lemwill/QuarkCncQuadDriver/README.md

# QuarkCnc

Inspired from:
https://github.com/Expatria-Technologies/grblhal_2000_PrintNC

https://github.com/grblHAL

3D View of QuarkCnc controller
