lemwill/QuarkCncQuadDriver/step/TS-1187A-B-A-B--3DModel-STEP-56544.STEP

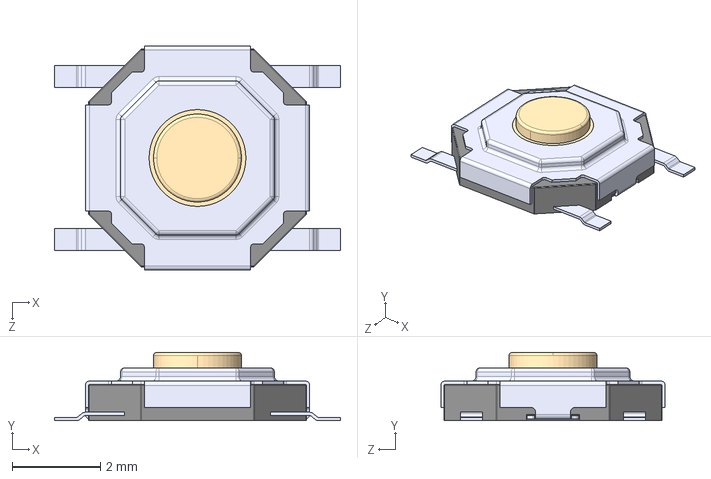
[picture p1: CAD file, 2022-08-06]
step/TS-1187A-B-A-B--3DModel-STEP-56544.STEP
6.50 x 1.55 x 5.10 mm
