lemwill/QuarkCncQuadDriver/QuarkCncQuadDriver.pdf

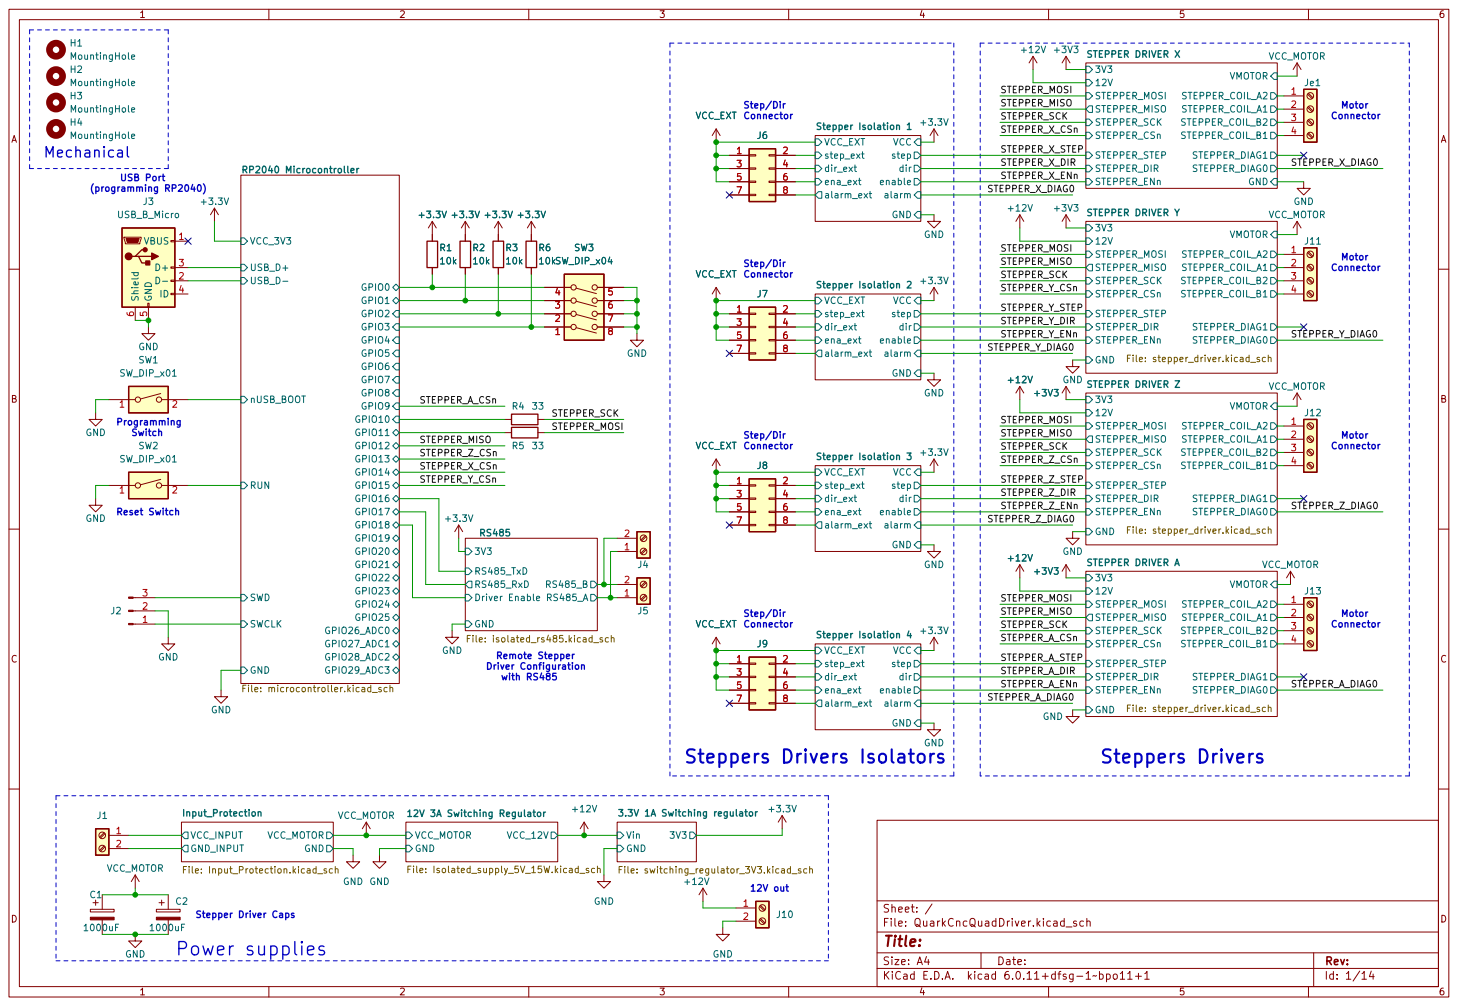
[picture p2: page 1]

3 3 | 4 4
5 5 | 6 6

3 3 | 4 4 | STEPPER_A_DIR

Id: 1/14 Title: File: QuarkCncQuadDriver.kicad_sch Sheet: /

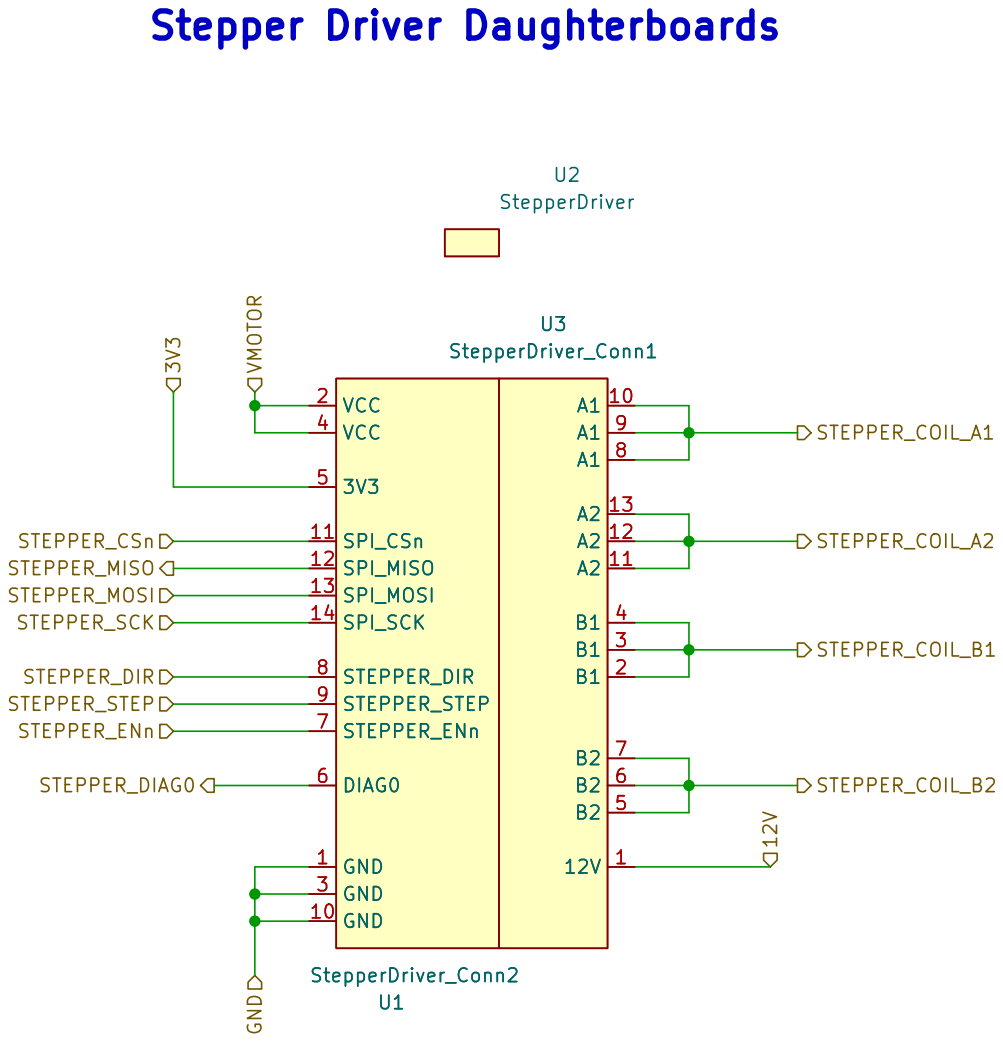
[picture p3: page 2]

Id: 2/14 Title: File: stepper_driver.kicad_sch Sheet: /STEPPER DRIVER Y/

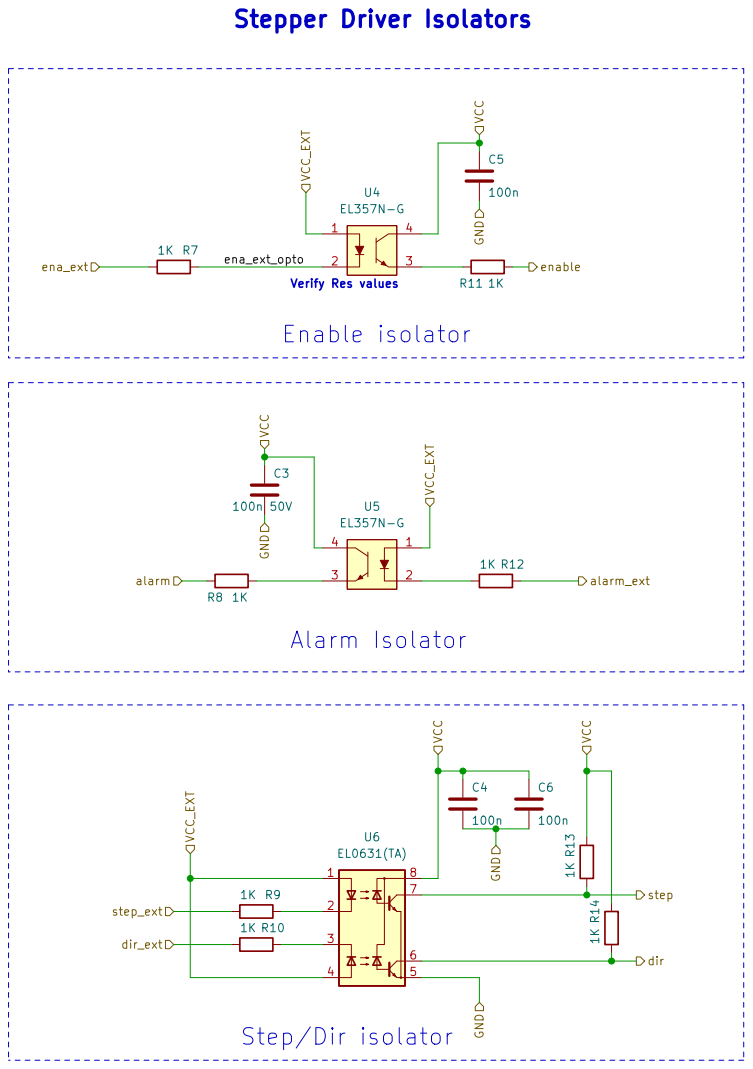
[picture p4: page 3]

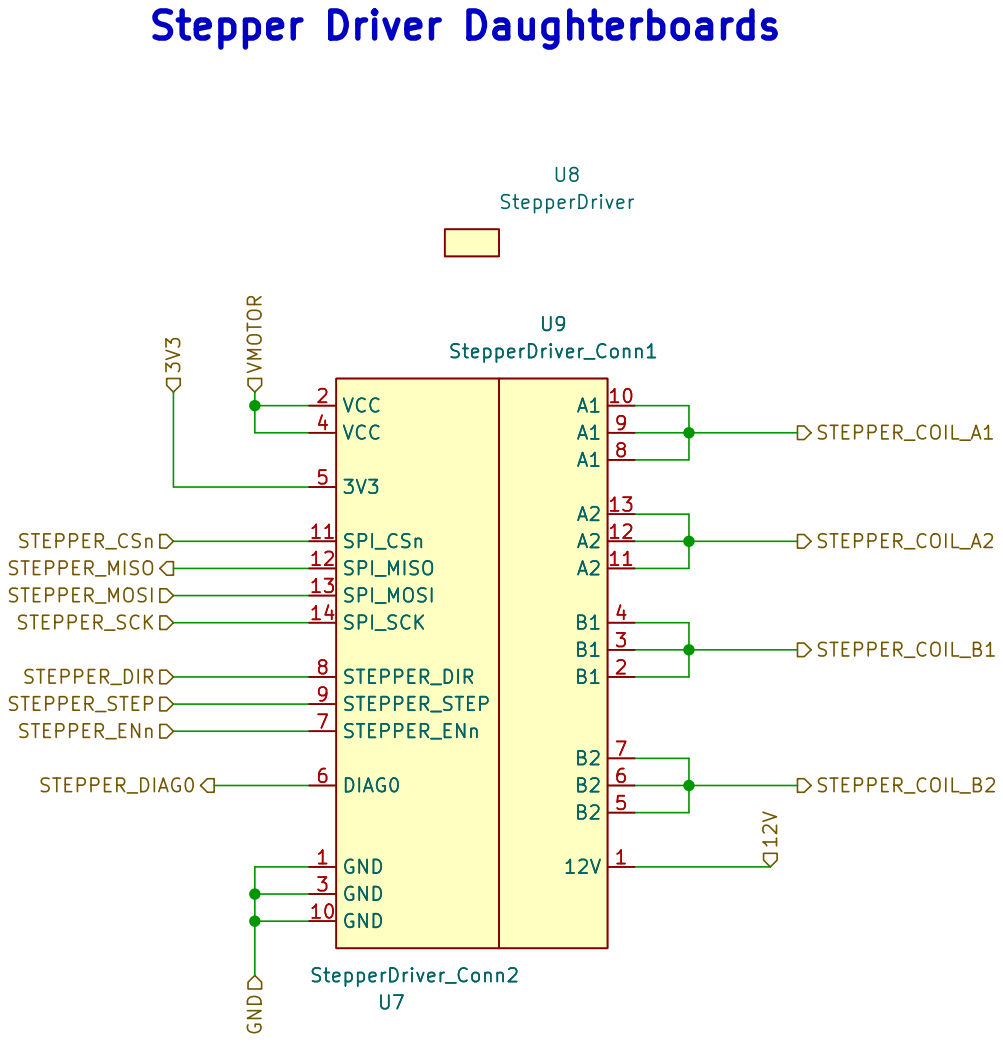
[picture p5: page 4]

Id: 4/14 Title: File: stepper_driver.kicad_sch Sheet: /STEPPER DRIVER X/

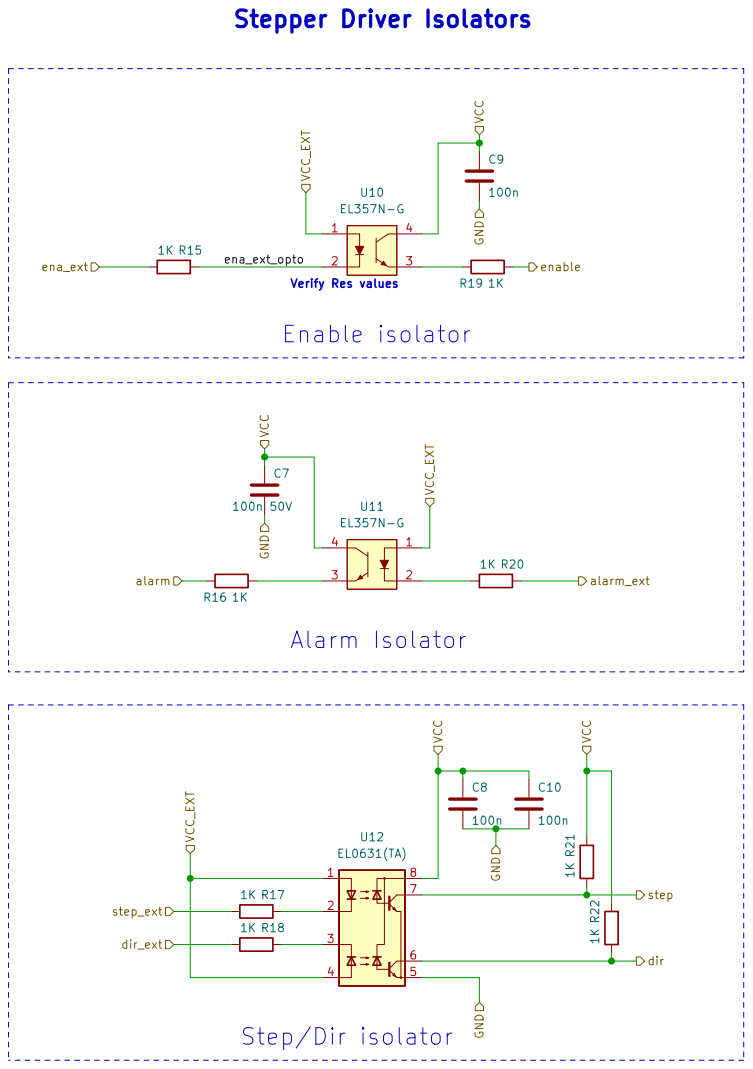
[picture p6: page 5]

Verify Res values Alarm Isolator
Enable isolator

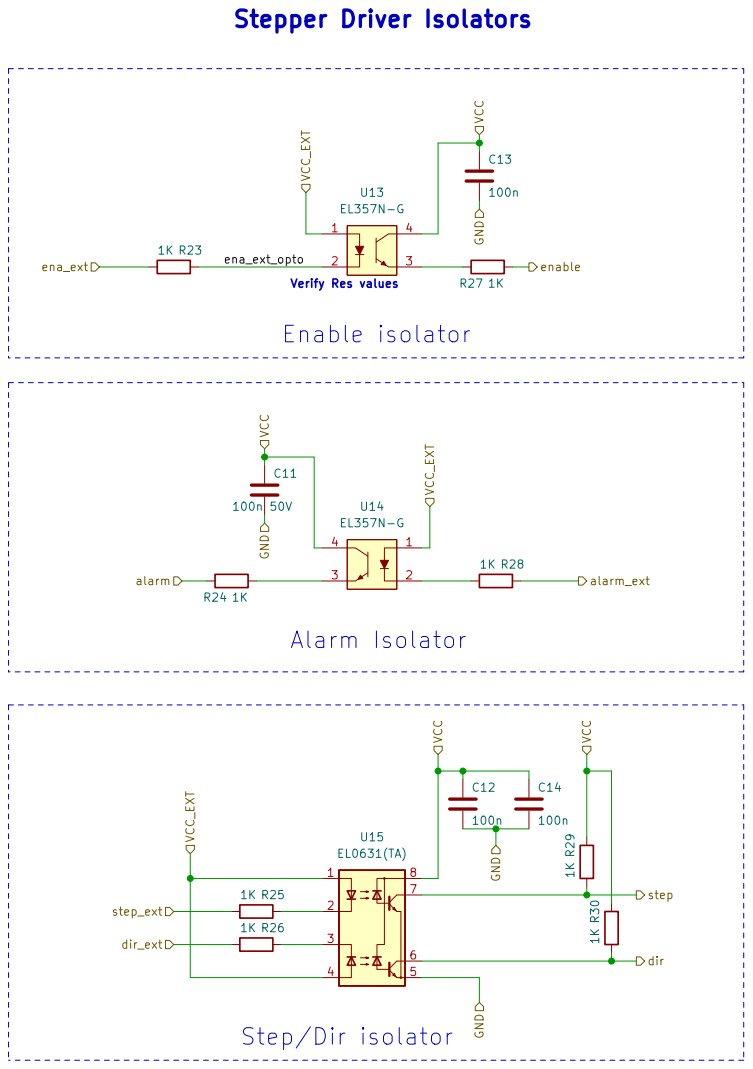
[picture p7: page 6]

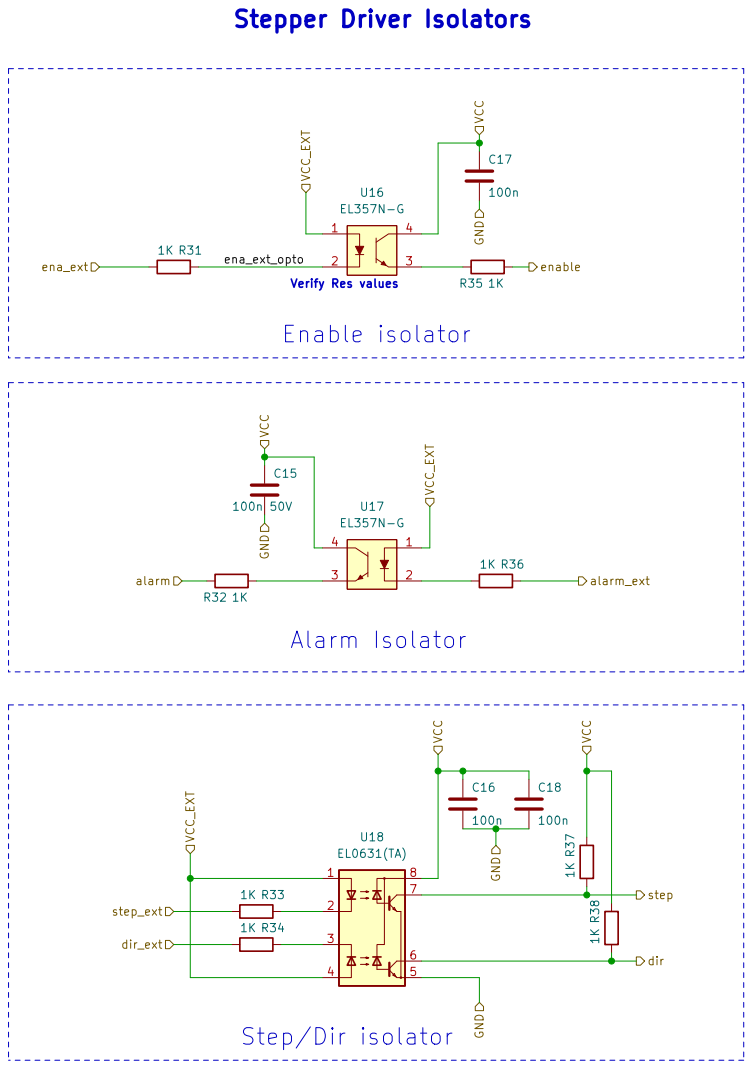
[picture p8: page 7]

dir VCC_EXT
Verify Res values Alarm Isolator
Enable isolator

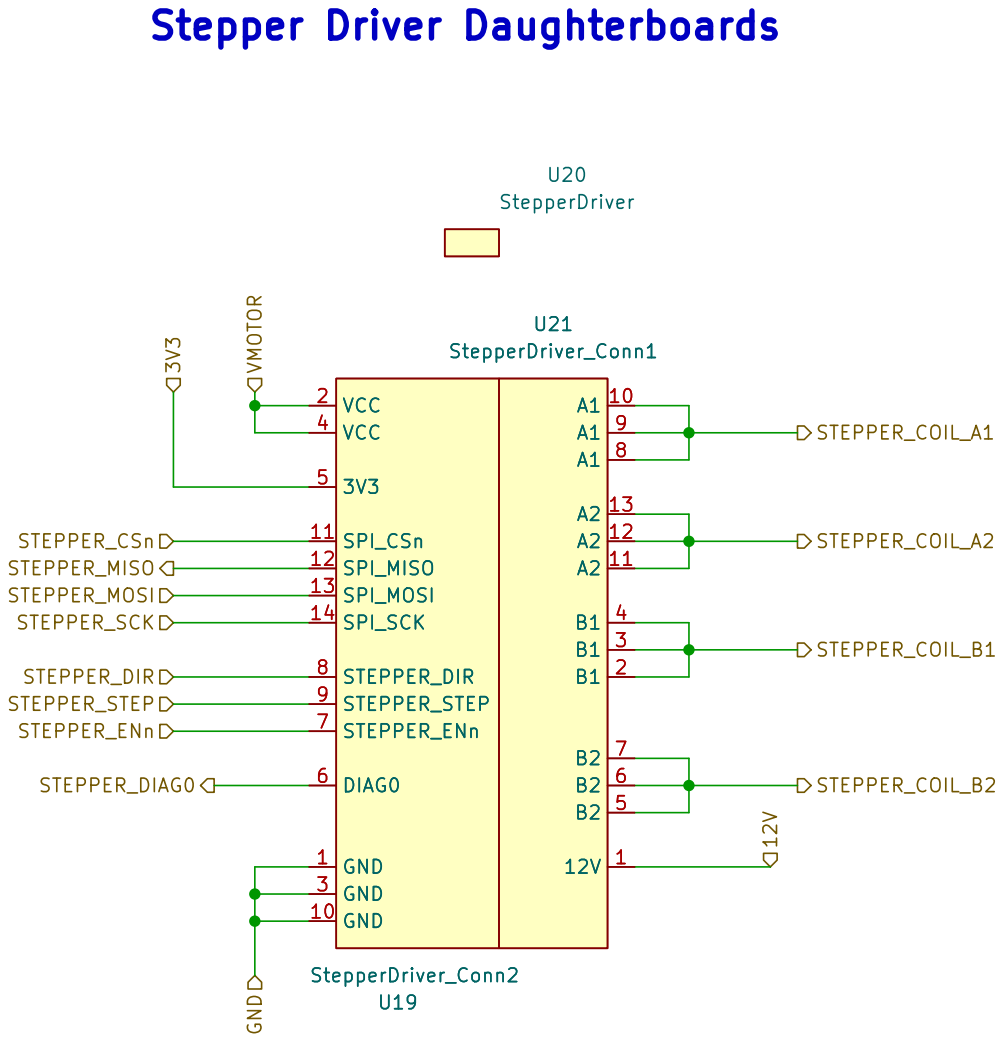
[picture p9: page 8]

Id: 11/14 Title: File: stepper_driver.kicad_sch Sheet: /STEPPER DRIVER Z/

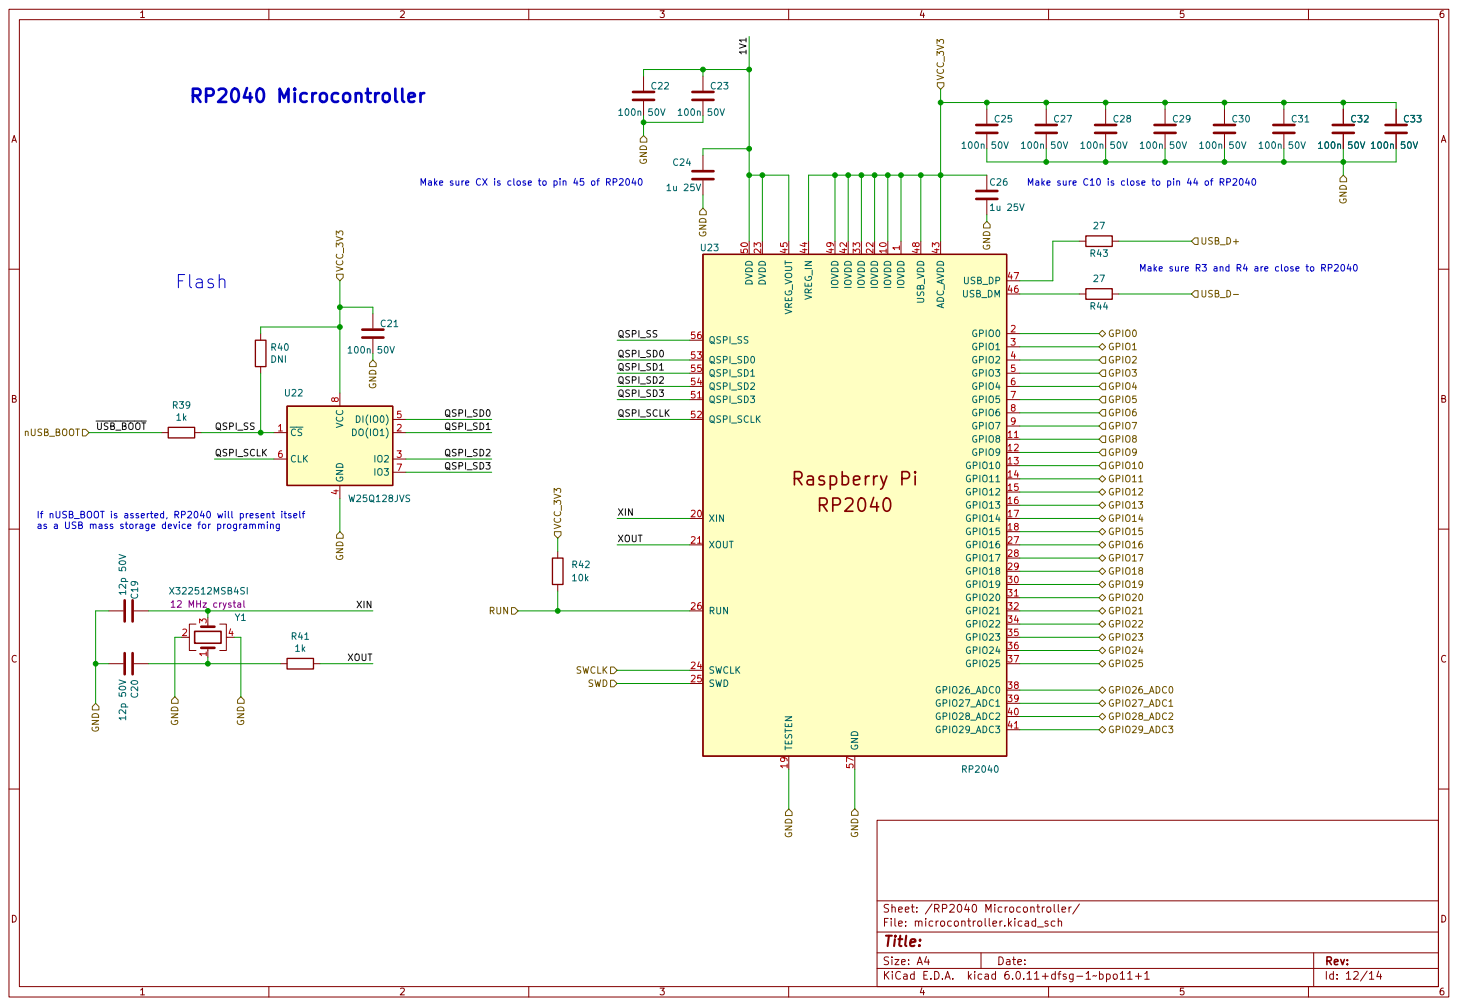
[picture p10: page 9]

Make sure C10 is close to pin 44 of RP2040

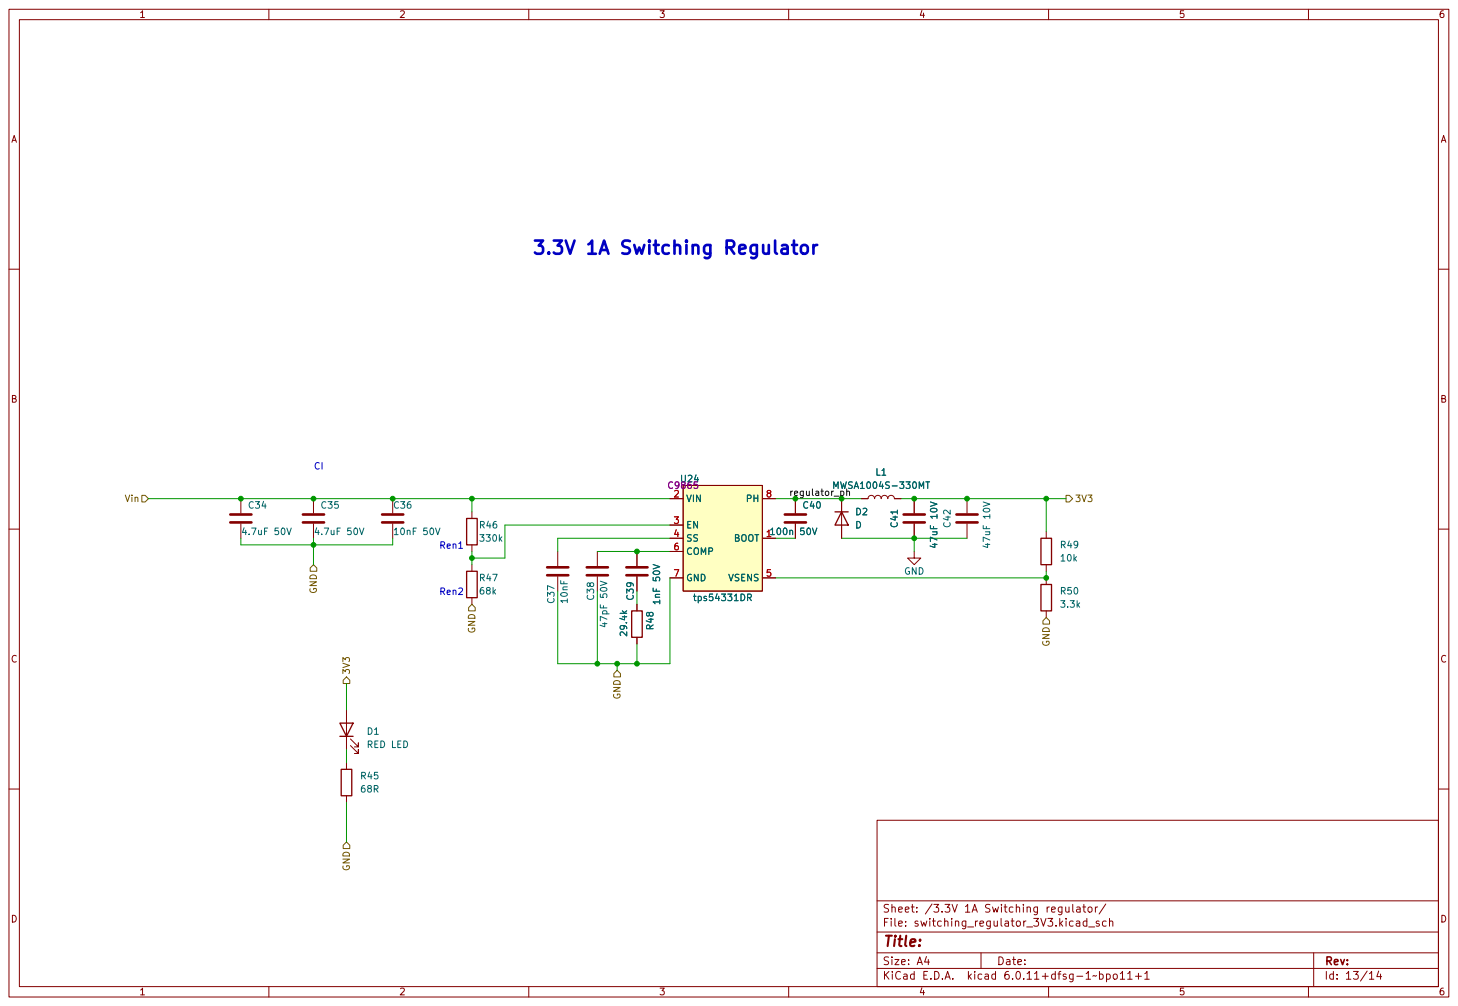
[picture p11: page 10]

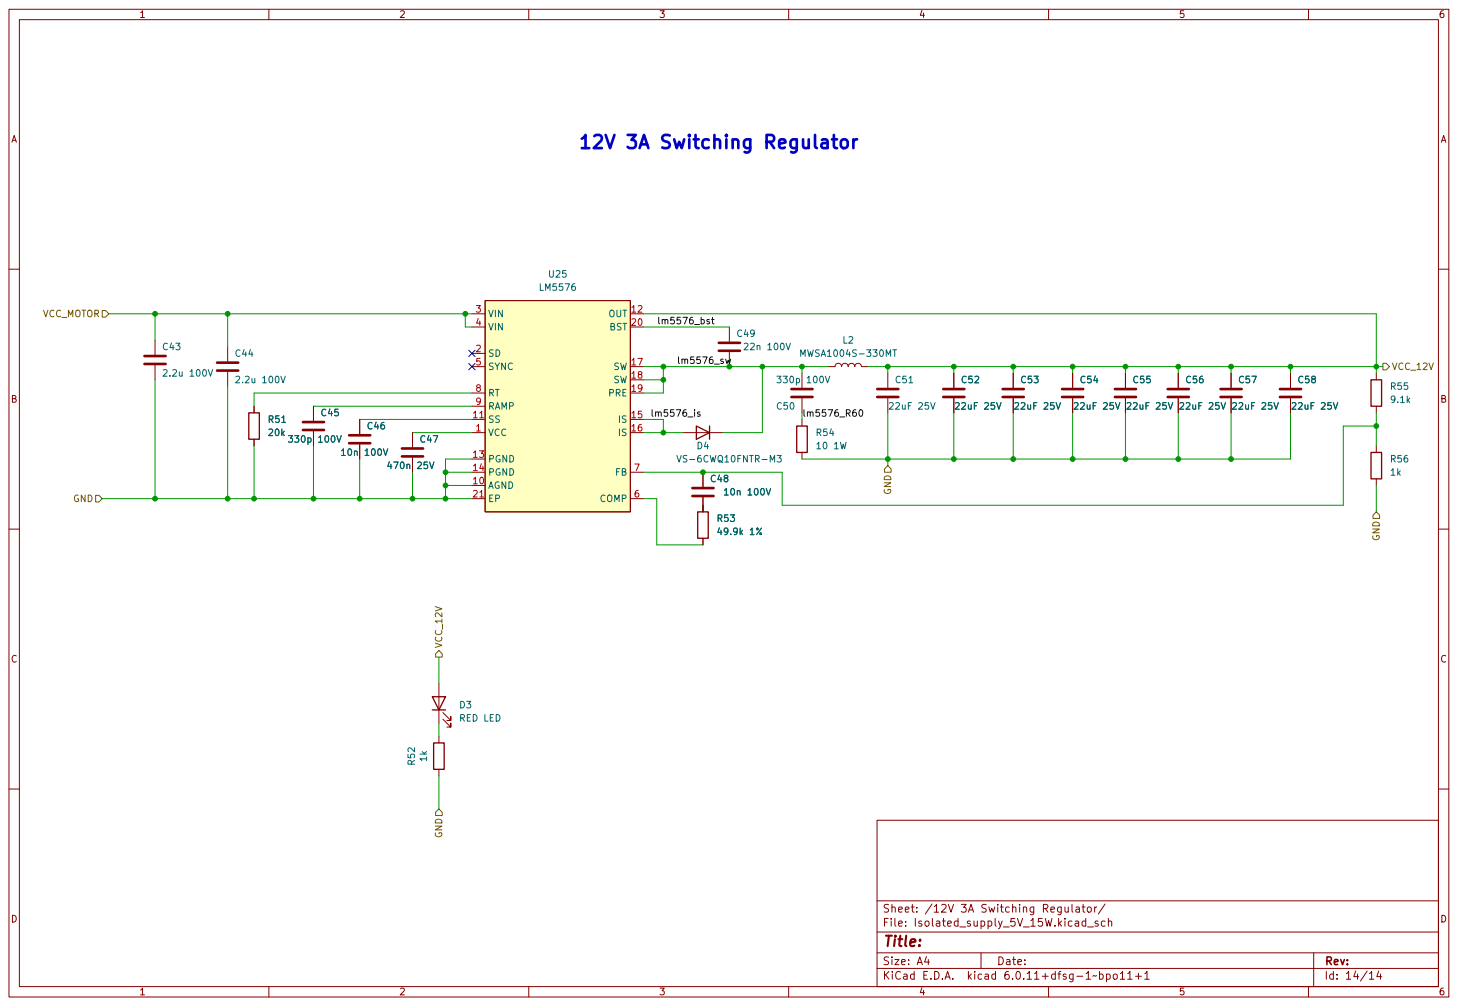
[picture p12: page 11]

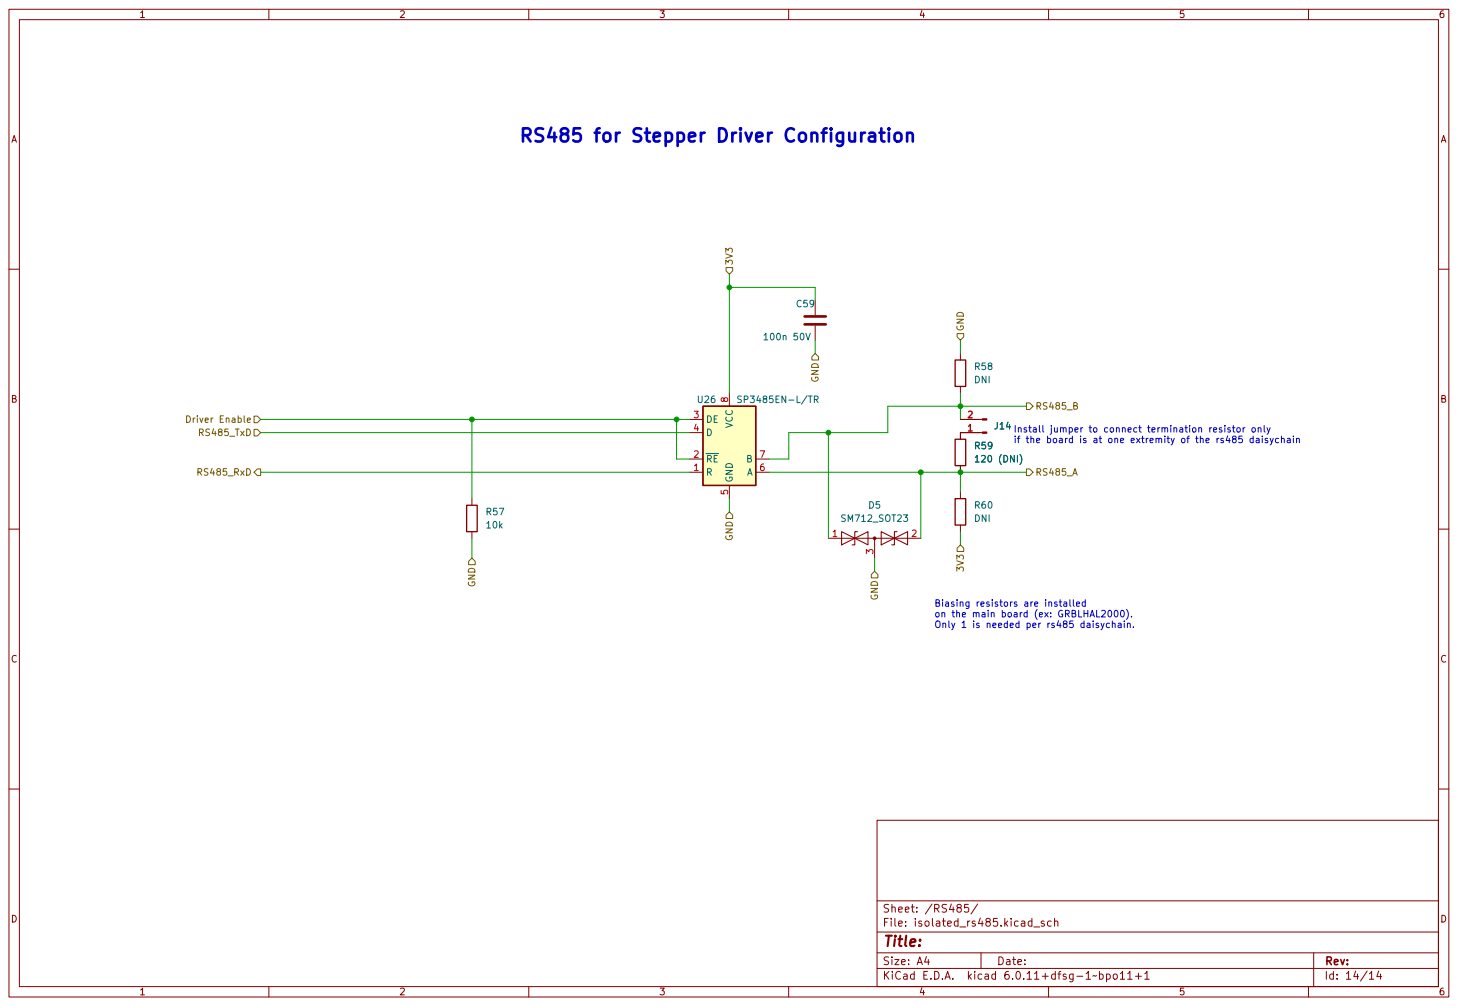
[picture p13: page 12]

on the main board (ex: GRBLHAL2000).
Only 1 is needed per rs485 daisychain.

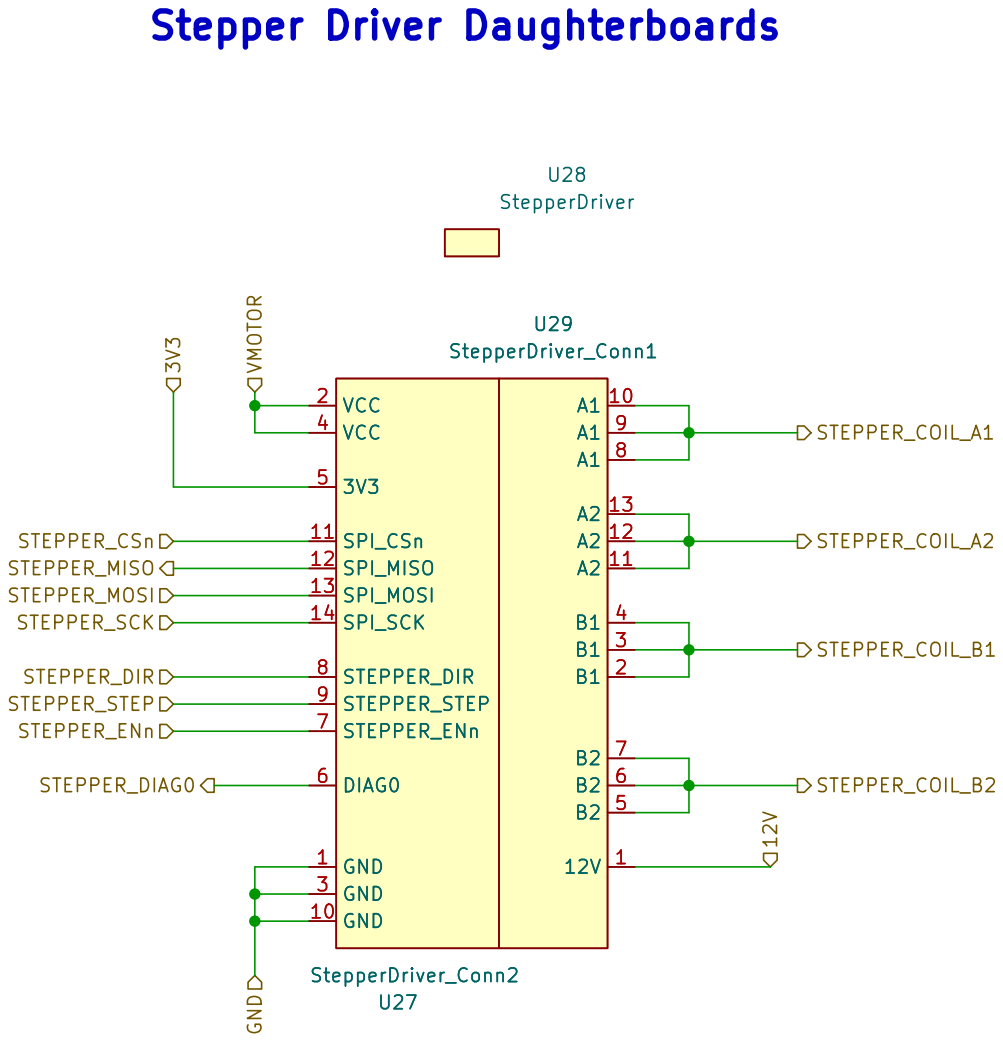
[picture p14: page 13]

Id: 15/14 Title: File: stepper_driver.kicad_sch Sheet: /STEPPER DRIVER A/

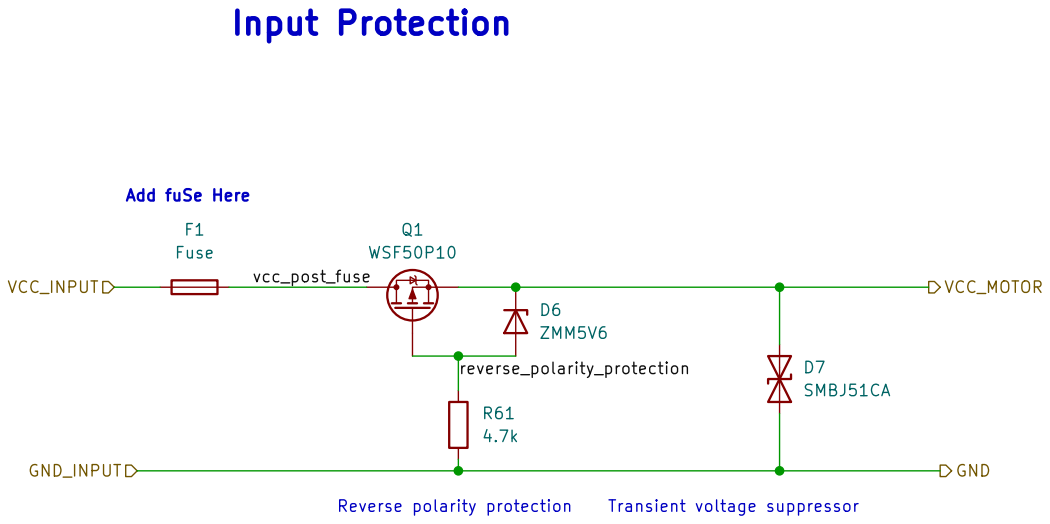
[picture p15: page 14]
