lemwill/QuarkCncQuadDriver/QuarkCncQuadDriver.kicad_pcb

## KiCad design QuarkCncQuadDriver.kicad_pcb (2022-09-21)

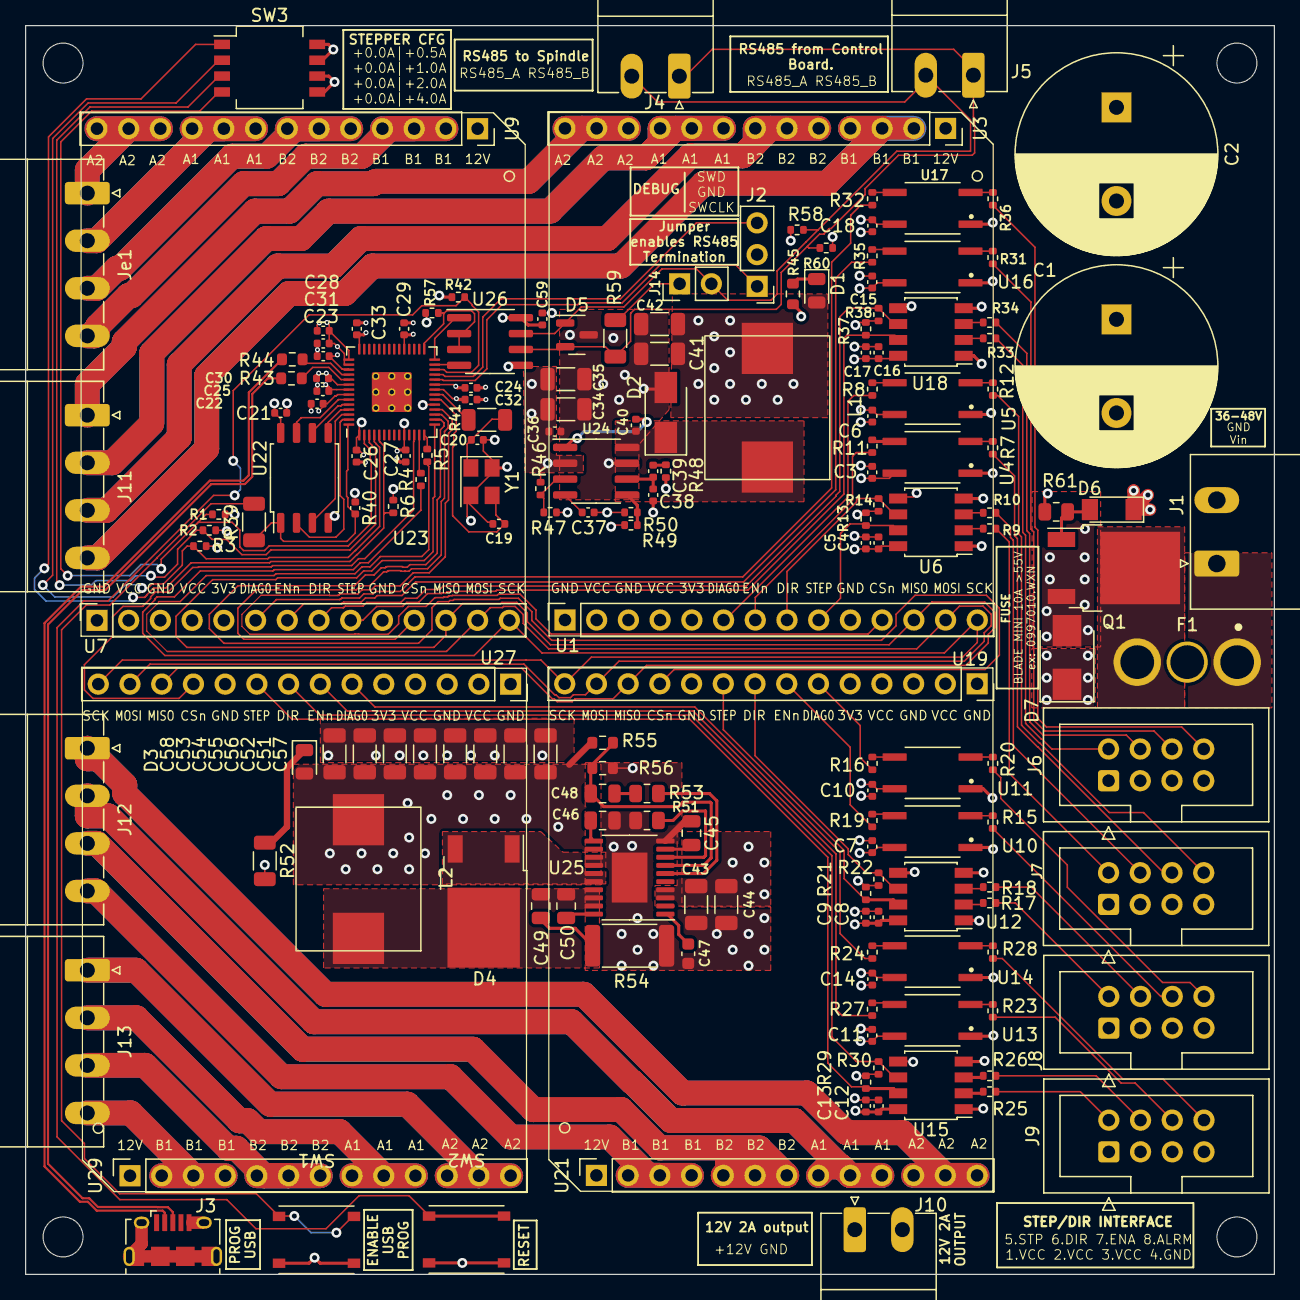
[picture p16: board QuarkCncQuadDriver.kicad_pcb from above]

Board: 4 copper layers, 100.0 x 100.0 mm, 183 parts (0 on the bottom side), 137 nets.

Parts:
C1, C2: 1000uF; CP_Radial_D16.0mm_P7.50mm
C3, C7, C11, C15, C21, C22, C23, C25, C27, C28, C29, C30, C31, C32, C33, C40, C59: 100n 50V; C_0402_1005Metric
C4, C5, C6, C8, C9, C10, C12, C13, C14, C16, C17, C18: 100n; C_0402_1005Metric
C19, C20: 12p 50V; C_0402_1005Metric
C24, C26: 1u 25V; C_0402_1005Metric
C34, C35: 4.7uF 50V; C_1206_3216Metric
C36: 10nF 50V; C_0402_1005Metric
C37: 10nF; C_0402_1005Metric
C38: 47pF 50V; C_0402_1005Metric
C39: 1nF 50V; C_0402_1005Metric
C41, C42: 47uF 10V; C_1206_3216Metric
C43, C44: 2.2u 100V; C_1206_3216Metric
C45, C50: 330p 100V; C_0805_2012Metric
C46, C48: 10n 100V; C_0805_2012Metric
C47: 470n 25V; C_0603_1608Metric
C49: 22n 100V; C_0805_2012Metric
C51, C52, C53, C54, C55, C56, C57, C58: 22uF 25V; C_1206_3216Metric
D1, D3: RED LED; LED_0805_2012Metric
D2: D; D_SMA
D4: VS-6CWQ10FNTR-M3
D5: SM712_SOT23; SOT-23
D6: ZMM5V6; D_MiniMELF
D7: SMBJ51CA; D_SMB
F1: Fuse; Fuse_Littelfuse_178.6764.0001
H1, H2, H3, H4: MountingHole; MountingHole_3.2mm_M3_ISO7380
J1: Screw_Terminal_01x02; PhoenixContact_MSTBA_2,5_2-G-5,08_1x02_P5.08mm_Horizontal
J2: Conn_01x03_Male; PinHeader_1x03_P2.54mm_Vertical
J3: USB_B_Micro; USB_Micro-B_Amphenol_10118194_Horizontal
J4, J5, J10: Screw_Terminal_01x02; PhoenixContact_MC_1,5_2-G-3.81_1x02_P3.81mm_Horizontal
J6, J7, J8, J9: Conn_02x04_Odd_Even; IDC-Header_2x04_P2.54mm_Vertical
J11, J12, J13: Screw_Terminal_01x04; PhoenixContact_MC_1,5_4-G-3.81_1x04_P3.81mm_Horizontal
J14: Conn_01x02_Male; PinHeader_1x02_P2.54mm_Vertical
Je1: Screw_Terminal_01x04; PhoenixContact_MC_1,5_4-G-3.81_1x04_P3.81mm_Horizontal
L1, L2: MWSA1004S-330MT
Q1: WSF50P10; TO-252-2
R1, R2, R3, R6, R42, R49, R57: 10k; R_0402_1005Metric
R4, R5: 33; R_0402_1005Metric
R7, R8, R9, R10, R11, R12, R13, R14, R15, R16, R17, R18, R19, R20, R21, R22, R23, R24, R25, R26, R27, R28, R29, R30, R31, R32, R33, R34, R35, R36, R37, R38: 1K; R_0402_1005Metric
R39, R41, R52: 1k; R_1206_3216Metric
R40: DNI; C_0402_1005Metric
R43, R44: 27; R_0603_1608Metric
R45: 68R; R_0603_1608Metric
R46: 330k; R_0402_1005Metric
R47: 68k; R_0402_1005Metric
R48: 29.4k; R_0402_1005Metric
R50: 3.3k; R_0402_1005Metric
R51: 20k; R_0805_2012Metric
R53: 49.9k 1%; R_0805_2012Metric
R54: 10 1W; R_2512_6332Metric
R55: 9.1k; R_0603_1608Metric
R56: 1k; R_0603_1608Metric
R58, R60: DNI; R_0402_1005Metric
R59: 120 (DNI); R_1206_3216Metric
R61: 4.7k; R_0805_2012Metric
SW1, SW2: SW_DIP_x01; TS-1187A-B-A-B
SW3: SW_DIP_x04; SW_DIP_SPSTx04_Slide_XKB_DSHP04TS-S_W6.35mm_P1.27mm
U1, U7, U19, U27: StepperDriver_Conn2; PinSocket_1x14_P2.54mm_Vertical
U2, U8, U20, U28: StepperDriver; StepperDriverV3
U3, U9, U21, U29: StepperDriver_Conn1; PinSocket_1x13_P2.54mm_Vertical
U4, U5, U10, U11, U13, U14, U16, U17: EL357N-G; SOP254P700X200-4N
U6, U12, U15, U18: EL0631(TA); SSOP-8_3.95x5.21x3.27mm_P1.27mm
U22: W25Q128JVS; SOIC-8_5.23x5.23mm_P1.27mm
U23: RP2040; RP2040-QFN-56
U24: tps54331DR; SOIC-8_3.9x4.9mm_P1.27mm
U25: LM5576; HTSSOP-20-1EP_4.4x6.5mm_P0.65mm_EP2.85x4mm
U26: SP3485EN-L/TR; SOIC-8_3.9x4.9mm_P1.27mm
Y1: X322512MSB4SI; Crystal_SMD_3225-4Pin_3.2x2.5mm

Connections:
+3V3: C3.1, C4.1, C5.1, C6.1, C7.1, C8.1, C9.1, C10.1, C11.1, C12.1, C13.1, C14.1, C15.1, C16.1, C17.1, C18.1, C21.1, C25.1, C26.1, C27.1, C28.1, C29.1, C30.1, C31.1, C32.1, C33.1, C41.2, C42.2, C59.1, D1.2 (A), L1.2, R1.1, R2.1, R3.1, R6.1, R13.2, R14.2, R21.2, R22.2, R29.2, R30.2, R37.2, R38.2, R40.1, R42.2, R49.1, R60.1, U1.5 (3V3), U4.4, U5.4, U6.8 (VCC), U7.5 (3V3), U10.4, U11.4, U12.8 (VCC), U13.4, U14.4, U15.8 (VCC), U16.4, U17.4, U18.8 (VCC), U19.5 (3V3), U22.8 (VCC), U23.1 (IOVDD), U23.10 (IOVDD), U23.22 (IOVDD), U23.33 (IOVDD), U23.42 (IOVDD), U23.43 (ADC_AVDD), U23.44 (VREG_IN), U23.48 (USB_VDD), U23.49 (IOVDD), U26.8 (VCC), U27.5 (3V3)
+12V: C34.1, C35.1, C36.1, C51.1, C52.1, C53.1, C54.1, C55.1, C56.1, C57.1, C58.1, D3.2 (A), J10.1, L2.2, R46.1, R55.1, U3.1 (12V), U9.1 (12V), U21.1 (12V), U24.2 (VIN), U25.12 (OUT), U29.1 (12V)
/3.3V 1A Switching regulator/regulator_ph: C40.1, D2.1 (K), L1.1, U24.8 (PH)
/12V 3A Switching Regulator/lm5576_R60: C50.2, R54.1
/12V 3A Switching Regulator/lm5576_bst: C49.1, U25.20 (BST)
/12V 3A Switching Regulator/lm5576_is: D4.2 (A), U25.15 (IS), U25.16 (IS)
/12V 3A Switching Regulator/lm5576_sw: C49.2, C50.1, D4.1 (K), L2.1, U25.17 (SW), U25.18 (SW), U25.19 (PRE)
/Input_Protection/VCC_INPUT: F1.1, J1.1
/Input_Protection/reverse_polarity_protection: D6.2 (A), Q1.1 (G), R61.1
/Input_Protection/vcc_post_fuse: F1.2, Q1.2 (D)
/RP2040 Microcontroller/1V1: C22.1, C23.1, C24.1, U23.23 (DVDD), U23.45 (VREG_VOUT), U23.50 (DVDD)
/RP2040 Microcontroller/GPIO0: R1.2, SW3.4, U23.2 (GPIO0)
/RP2040 Microcontroller/GPIO1: R2.2, SW3.3, U23.3 (GPIO1)
/RP2040 Microcontroller/GPIO2: R3.2, SW3.2, U23.4 (GPIO2)
/RP2040 Microcontroller/GPIO3: R6.2, SW3.1, U23.5 (GPIO3)
/RP2040 Microcontroller/GPIO10: R4.2, U23.13 (GPIO10)
/RP2040 Microcontroller/GPIO11: R5.2, U23.14 (GPIO11)
/RP2040 Microcontroller/GPIO16: U23.27 (GPIO16), U26.4 (D)
/RP2040 Microcontroller/GPIO17: U23.28 (GPIO17), U26.1 (R)
/RP2040 Microcontroller/GPIO18: R57.2, U23.29 (GPIO18), U26.2 (~RE), U26.3 (DE)
/RP2040 Microcontroller/QSPI_SCLK: U22.6 (CLK), U23.52 (QSPI_SCLK)
/RP2040 Microcontroller/QSPI_SD0: U22.5 (DI(IO0)), U23.53 (QSPI_SD0)
/RP2040 Microcontroller/QSPI_SD1: U22.2 (DO(IO1)), U23.55 (QSPI_SD1)
/RP2040 Microcontroller/QSPI_SD2: U22.3 (IO2), U23.54 (QSPI_SD2)
/RP2040 Microcontroller/QSPI_SD3: U22.7 (IO3), U23.51 (QSPI_SD3)
/RP2040 Microcontroller/QSPI_SS: R39.1, R40.2, U22.1 (~CS), U23.56 (QSPI_SS)
/RP2040 Microcontroller/RUN: R42.1, SW2.2, U23.26 (RUN)
/RP2040 Microcontroller/SWCLK: J2.1, U23.24 (SWCLK)
/RP2040 Microcontroller/SWD: J2.3, U23.25 (SWD)
/RP2040 Microcontroller/USB_D+: J3.3 (D+), R43.1
/RP2040 Microcontroller/USB_D-: J3.2 (D-), R44.1
/RP2040 Microcontroller/XIN: C19.1, U23.20 (XIN), Y1.3
/RP2040 Microcontroller/XOUT: R41.1, U23.21 (XOUT)
/RP2040 Microcontroller/~USB_BOOT: R39.2, SW1.2
/RS485/RS485_A: D5.2 (A2), J4.1, J5.1, R59.1, R60.2, U26.6 (A)
/RS485/RS485_B: D5.1 (A1), J4.2, J5.2, J14.2, R58.1, U26.7 (B)
/STEPPER DRIVER A/STEPPER_COIL_A1: J13.2, U29.8 (A1), U29.9 (A1), U29.10 (A1)
/STEPPER DRIVER A/STEPPER_COIL_A2: J13.1, U29.11 (A2), U29.12 (A2), U29.13 (A2)
/STEPPER DRIVER A/STEPPER_COIL_B1: J13.4, U29.2 (B1), U29.3 (B1), U29.4 (B1)
/STEPPER DRIVER A/STEPPER_COIL_B2: J13.3, U29.5 (B2), U29.6 (B2), U29.7 (B2)
/STEPPER DRIVER X/STEPPER_COIL_A1: Je1.2, U9.8 (A1), U9.9 (A1), U9.10 (A1)
/STEPPER DRIVER X/STEPPER_COIL_A2: Je1.1, U9.11 (A2), U9.12 (A2), U9.13 (A2)
/STEPPER DRIVER X/STEPPER_COIL_B1: Je1.4, U9.2 (B1), U9.3 (B1), U9.4 (B1)
/STEPPER DRIVER X/STEPPER_COIL_B2: Je1.3, U9.5 (B2), U9.6 (B2), U9.7 (B2)
/STEPPER DRIVER Y/STEPPER_COIL_A1: J11.2, U3.8 (A1), U3.9 (A1), U3.10 (A1)
/STEPPER DRIVER Y/STEPPER_COIL_A2: J11.1, U3.11 (A2), U3.12 (A2), U3.13 (A2)
/STEPPER DRIVER Y/STEPPER_COIL_B1: J11.4, U3.2 (B1), U3.3 (B1), U3.4 (B1)
/STEPPER DRIVER Y/STEPPER_COIL_B2: J11.3, U3.5 (B2), U3.6 (B2), U3.7 (B2)
/STEPPER DRIVER Z/STEPPER_COIL_A1: J12.2, U21.8 (A1), U21.9 (A1), U21.10 (A1)
/STEPPER DRIVER Z/STEPPER_COIL_A2: J12.1, U21.11 (A2), U21.12 (A2), U21.13 (A2)
/STEPPER DRIVER Z/STEPPER_COIL_B1: J12.4, U21.2 (B1), U21.3 (B1), U21.4 (B1)
/STEPPER DRIVER Z/STEPPER_COIL_B2: J12.3, U21.5 (B2), U21.6 (B2), U21.7 (B2)
/STEPPER_A_CSn: U23.12 (GPIO9), U27.11 (SPI_CSn)
/STEPPER_A_DIAG0: R24.2, U27.6 (DIAG0)
/STEPPER_A_DIR: R30.1, U15.6 (VO2), U27.8 (STEPPER_DIR)
/STEPPER_A_ENn: R27.1, U27.7 (STEPPER_ENn)
/STEPPER_A_STEP: R29.1, U15.7 (VO1), U27.9 (STEPPER_STEP)
/STEPPER_MISO: U1.12 (SPI_MISO), U7.12 (SPI_MISO), U19.12 (SPI_MISO), U23.15 (GPIO12), U27.12 (SPI_MISO)
/STEPPER_MOSI: R5.1, U1.13 (SPI_MOSI), U7.13 (SPI_MOSI), U19.13 (SPI_MOSI), U27.13 (SPI_MOSI)
/STEPPER_SCK: R4.1, U1.14 (SPI_SCK), U7.14 (SPI_SCK), U19.14 (SPI_SCK), U27.14 (SPI_SCK)
/STEPPER_X_CSn: U7.11 (SPI_CSn), U23.17 (GPIO14)
/STEPPER_X_DIAG0: R32.2, U7.6 (DIAG0)
/STEPPER_X_DIR: R38.1, U7.8 (STEPPER_DIR), U18.6 (VO2)
/STEPPER_X_ENn: R35.1, U7.7 (STEPPER_ENn)
/STEPPER_X_STEP: R37.1, U7.9 (STEPPER_STEP), U18.7 (VO1)
/STEPPER_Y_CSn: U1.11 (SPI_CSn), U23.18 (GPIO15)
/STEPPER_Y_DIAG0: R8.2, U1.6 (DIAG0)
/STEPPER_Y_DIR: R14.1, U1.8 (STEPPER_DIR), U6.6 (VO2)
/STEPPER_Y_ENn: R11.1, U1.7 (STEPPER_ENn)
/STEPPER_Y_STEP: R13.1, U1.9 (STEPPER_STEP), U6.7 (VO1)
/STEPPER_Z_CSn: U19.11 (SPI_CSn), U23.16 (GPIO13)
/STEPPER_Z_DIAG0: R16.2, U19.6 (DIAG0)
/STEPPER_Z_DIR: R22.1, U12.6 (VO2), U19.8 (STEPPER_DIR)
/STEPPER_Z_ENn: R19.1, U19.7 (STEPPER_ENn)
/STEPPER_Z_STEP: R21.1, U12.7 (VO1), U19.9 (STEPPER_STEP)
/Stepper Isolation 1/alarm_ext: J6.8, R36.2
/Stepper Isolation 1/dir_ext: J6.4, R34.1
/Stepper Isolation 1/ena_ext: J6.6, R31.1
/Stepper Isolation 1/ena_ext_opto: R31.2, U16.2
/Stepper Isolation 1/step_ext: J6.2, R33.1
/Stepper Isolation 2/alarm_ext: J7.8, R12.2
/Stepper Isolation 2/dir_ext: J7.4, R10.1
/Stepper Isolation 2/ena_ext: J7.6, R7.1
/Stepper Isolation 2/ena_ext_opto: R7.2, U4.2
/Stepper Isolation 2/step_ext: J7.2, R9.1
/Stepper Isolation 3/alarm_ext: J8.8, R20.2
/Stepper Isolation 3/dir_ext: J8.4, R18.1
/Stepper Isolation 3/ena_ext: J8.6, R15.1
/Stepper Isolation 3/ena_ext_opto: R15.2, U10.2
/Stepper Isolation 3/step_ext: J8.2, R17.1
/Stepper Isolation 4/alarm_ext: J9.8, R28.2
/Stepper Isolation 4/dir_ext: J9.4, R26.1
/Stepper Isolation 4/ena_ext: J9.6, R23.1
/Stepper Isolation 4/ena_ext_opto: R23.2, U13.2
/Stepper Isolation 4/step_ext: J9.2, R25.1
GND: C1.2, C2.2, C3.2, C4.2, C5.2, C6.2, C7.2, C8.2, C9.2, C10.2, C11.2, C12.2, C13.2, C14.2, C15.2, C16.2, C17.2, C18.2, C19.2, C20.2, C21.2, C22.2, C23.2, C24.2, C25.2, C26.2, C27.2, C28.2, C29.2, C30.2, C31.2, C32.2, C33.2, C34.2, C35.2, C36.2, C37.2, C38.2, C41.1, C42.1, C43.2, C44.2, C45.2, C46.2, C47.2, C51.2, C52.2, C53.2, C54.2, C55.2, C56.2, C57.2, C58.2, C59.2, D2.2 (A), D5.3 (common), D7.1 (A1), J1.2, J2.2, J3.5 (GND), J3.6 (Shield), J10.2, R45.2, R47.2, R48.2, R50.2, R51.2, R52.2, R54.2, R56.2, R57.1, R58.2, R61.2, SW1.1, SW2.1, SW3.5, SW3.6, SW3.7, SW3.8, U1.1 (GND), U1.3 (GND), U1.10 (GND), U6.5 (GND), U7.1 (GND), U7.3 (GND), U7.10 (GND), U12.5 (GND), U15.5 (GND), U18.5 (GND), U19.1 (GND), U19.3 (GND), U19.10 (GND), U22.4 (GND), U23.19 (TESTEN), U23.57 (GND), U24.7 (GND), U25.10 (AGND), U25.13 (PGND), U25.14 (PGND), U25.21 (EP), U26.5 (GND), U27.1 (GND), U27.3 (GND), U27.10 (GND), Y1.2, Y1.4
unnamed: C20.1, R41.2, Y1.1
unnamed: C37.1, U24.4 (SS)
unnamed: C38.1, C39.1, U24.6 (COMP)
unnamed: C39.2, R48.1
unnamed: C40.2, U24.1 (BOOT)
unnamed: C45.1, U25.9 (RAMP)
unnamed: C46.1, U25.11 (SS)
unnamed: C47.1, U25.1 (VCC)
unnamed: C48.1, R55.2, R56.1, U25.7 (FB)
unnamed: C48.2, R53.1
unnamed: D1.1 (K), R45.1
unnamed: D3.1 (K), R52.1
unnamed: J14.1, R59.2
unnamed: R8.1, U5.3
unnamed: R9.2, U6.2 (C1)
unnamed: R10.2, U6.3 (C2)
unnamed: R11.2, U4.3
unnamed: R12.1, U5.2
unnamed: R16.1, U11.3
unnamed: R17.2, U12.2 (C1)
unnamed: R18.2, U12.3 (C2)
unnamed: R19.2, U10.3
unnamed: R20.1, U11.2
unnamed: R24.1, U14.3
unnamed: R25.2, U15.2 (C1)
unnamed: R26.2, U15.3 (C2)
unnamed: R27.2, U13.3
unnamed: R28.1, U14.2
unnamed: R32.1, U17.3
unnamed: R33.2, U18.2 (C1)
unnamed: R34.2, U18.3 (C2)
unnamed: R35.2, U16.3
unnamed: R36.1, U17.2
unnamed: R43.2, U23.47 (USB_DP)
unnamed: R44.2, U23.46 (USB_DM)
unnamed: R46.2, R47.1, U24.3 (EN)
unnamed: R49.2, R50.1, U24.5 (VSENS)
unnamed: R51.1, U25.8 (RT)
unnamed: R53.2, U25.6 (COMP)
VCC: C1.1, C2.1, C43.1, C44.1, D6.1 (K), D7.2 (A2), Q1.3 (D), U1.2 (VCC), U1.4 (VCC), U7.2 (VCC), U7.4 (VCC), U19.2 (VCC), U19.4 (VCC), U25.3 (VIN), U25.4 (VIN), U27.2 (VCC), U27.4 (VCC)
VCC_EXT: J6.1, J6.3, J6.5, J7.1, J7.3, J7.5, J8.1, J8.3, J8.5, J9.1, J9.3, J9.5, U4.1, U5.1, U6.1 (A1), U6.4 (A2), U10.1, U11.1, U12.1 (A1), U12.4 (A2), U13.1, U14.1, U15.1 (A1), U15.4 (A2), U16.1, U17.1, U18.1 (A1), U18.4 (A2)
