lemwill/QuarkCncQuadDriver/(commit log)

2022-08-23 Added MFG files
    [QuarkCncQuadDriver-CuBottom.gbr, QuarkCncQuadDriver-CuIn1.gbr, QuarkCncQuadDriver-CuIn2.gbr, QuarkCncQuadDriver-CuTop.gbr, QuarkCncQuadDriver-EdgeCuts.gbr, QuarkCncQuadDriver-MaskBottom.gbr, QuarkCncQuadDriver-MaskTop.gbr, QuarkCncQuadDriver-NPTH.drl]
2022-08-23 Added assembly files
    [BOM-GrblHal2000Drivers.csv, BOM-QuarkCncQuadDriver.csv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]
2022-09-04 Fixed reset/boot button footprint
    [BOM-QuarkCncQuadDriver.csv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]
2022-09-21 Keyed stepper drivers. Larger input connector
    [Isolated_supply_5V_15W.kicad_sch, QuarkCncQuadDriver.kicad_pcb, QuarkCncQuadDriver.kicad_sch, isolated_rs485.kicad_sch, microcontroller.kicad_sch, stepper_driver.kicad_sch, switching_regulator_3V3.kicad_sch]
2023-05-20 Add schematic PDF
